Jbruslind/IntegratedStepper/README.md

# IntegratedStepper
Integrated Stepper Motor Node
