Jbruslind/IntegratedStepper/Mechanical/NEMA17_NEMA11_Adapter.SLDPRT

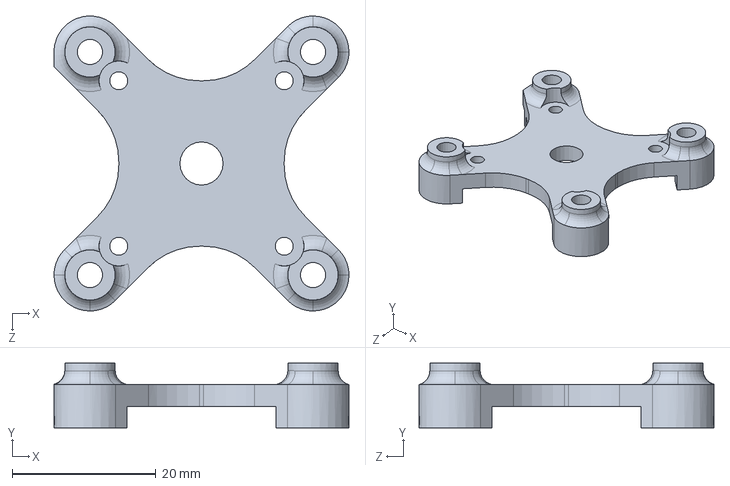
[picture p1: CAD file, 2024-04-22]
Mechanical/NEMA17_NEMA11_Adapter.SLDPRT
41.0 x 9.00 x 41.0 mm
