Jbruslind/IntegratedStepper/(list of files, cad)

Other CAD files:
Mechanical/NEMA17_NEMA11_Adapter.3MF
