Jbruslind/IntegratedStepper/PCB/IntegratedStepper/IntegratedStepper.kicad_pcb

## KiCad design PCB/IntegratedStepper/IntegratedStepper.kicad_pcb (2024-07-10)

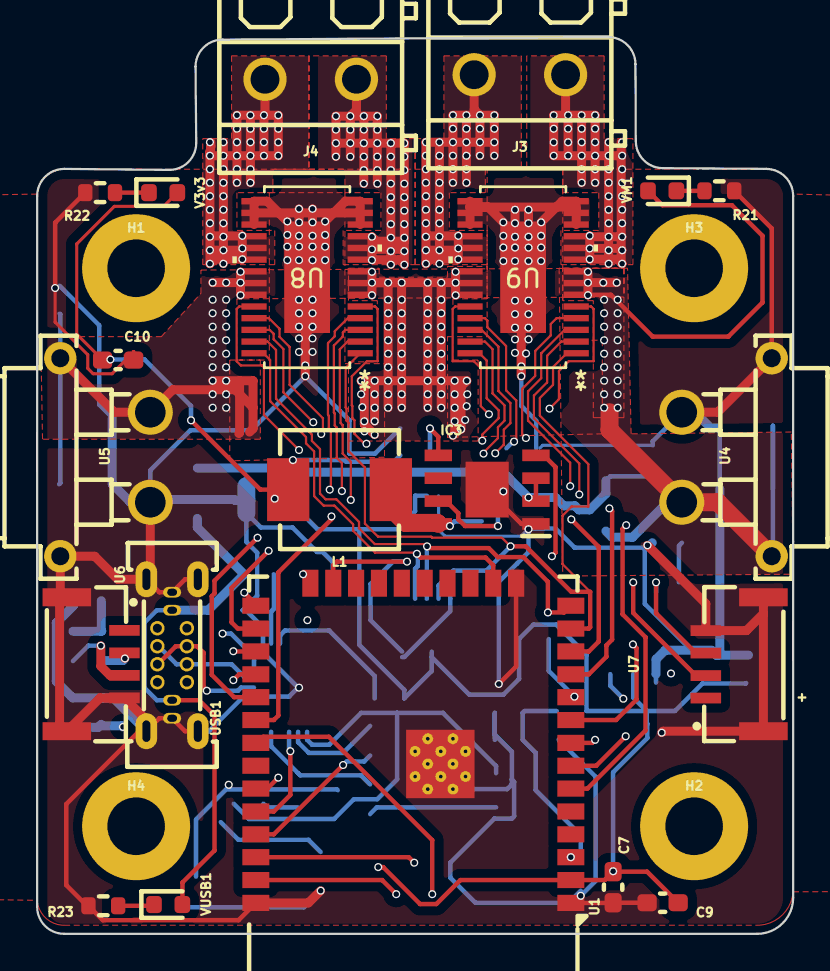
[picture p2: board IntegratedStepper.kicad_pcb from above]

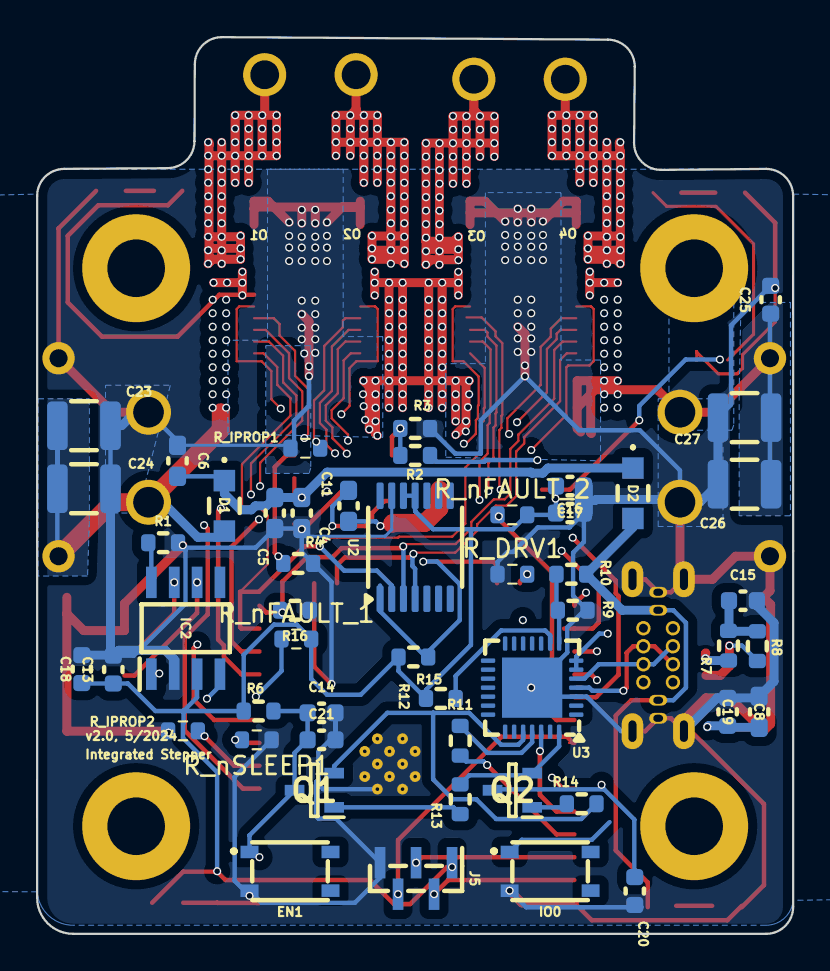
[picture p3: board IntegratedStepper.kicad_pcb from below]

Board: 4 copper layers, 42.0 x 49.8 mm, 75 parts (50 on the bottom side), 54 nets.

Parts:
C4, C7, C10: 10uf; C_0603_1608Metric_Pad1.08x0.95mm_HandSolder
C5, C9: 1uF; C_0603_1608Metric_Pad1.08x0.95mm_HandSolder
C6, C8: 100nf; C_0603_1608Metric_Pad1.08x0.95mm_HandSolder
C11: 0.1uF; C_0603_1608Metric_Pad1.08x0.95mm_HandSolder
C13, C14, C17, C18, C20, C21: 0.1uF; C_0603_1608Metric
C15: 4.7nF; C_0603_1608Metric
C16, C19, C25: 10uF; C_0603_1608Metric
C23: 22uF; C_1210_3225Metric
C24, C26, C27: 10uF; C_1210_3225Metric
D1, D2: PMEG6020ER,115; PMEG6020ER115
EN1: PTS815_SJG_250_SMTR_LFS; PTS815SJM250SMTRLFS
H1, H2, H3, H4: MountingHole_Pad; MountingHole_3.2mm_M3
IC2: SN65HVD230DR; SOT127P600X175-8N
IC3: LMR38020FSQDDARQ1; SOIC127P600X170-9N
IO0: PTS815_SJG_250_SMTR_LFS; PTS815SJM250SMTRLFS
J3, J4: Screw_Terminal_01x02; CONN-TH_P5.08_KF128-5.08-2P
J5: Conn_01x05_Socket; PinHeader_1x05_P1.00mm_Vertical_SMD_Pin1Left
L1: 10uH; IND-SMD_L7.2-W6.6_GPSR07X0
Q1, Q2: SS8050-G; SOT95P240X115-3N
R1, R13, R14, R15, R16, R21: 8.2k; R_0603_1608Metric
R2: 154k; R_0603_1608Metric
R3, R4: 64.9k; R_0603_1608Metric
R6: 10k; R_0603_1608Metric
R7, R8: 60; R_0603_1608Metric
R9: 47.5k; R_0603_1608Metric
R10: 22.1k; R_0603_1608Metric
R11: 10; R_0603_1608Metric
R12: 2k; R_0603_1608Metric
R22, R23: 500; R_0603_1608Metric
R_DRV1: 8.2k; R_0603_1608Metric
R_IPROP1, R_IPROP2: 820; R_0603_1608Metric
R_nFAULT_1, R_nFAULT_2: 8.2k; R_0603_1608Metric
R_nSLEEP1: 8.2k; R_0603_1608Metric
U1: ESP32-WROOM-32E; ESP32-WROOM-32D
U2: AS5048A; TSSOP-14_4.4x5mm_P0.65mm
U3: CP2102N-Axx-xQFN28; QFN-28-1EP_5x5mm_P0.5mm_EP3.35x3.35mm
U4, U5: XT30PW-F; CONN-TH_XT30PW-F-1
U6, U7: SM04B-GHS-TB(LF)(SN); CONN-SMD_4P-P1.25_SM04B-GHS-TB-LF-SN
U8, U9: PDRV8245SPWPQ1; U_PWP0028R_TEX
USB1: GT-USB-7038C; USB-C-TH_G-SWITCH_GT-USB-7038X
V3v3: LED; LED_0603_1608Metric
VM1: LED; LED_0603_1608Metric
VUSB1: LED; LED_0603_1608Metric

Connections:
3V3_VCC: C7.1, C8.1, C9.1, C10.1, C13.1, C16.1, C17.1, C18.1, C19.1, IC2.3 (VCC), J5.1, L1.2, R2.1, R6.1, R12.2, R15.2, R_nFAULT_1.2, R_nFAULT_2.2, U1.2 (VDD), U2.11 (VDD5V), U2.12 (VDD3V), U3.6 (VDD), U3.7 (VREGIN), V3v3.2 (A)
/3V3_VReg/VM: C23.1, C24.1, C25.1, C26.1, C27.1, D1.2 (A), U4.1, U4.4, U5.1, U5.4, U8.6 (VM), U8.7 (VM), U8.8 (VM), U8.21 (VM), U8.22 (VM), U8.23 (VM), U9.6 (VM), U9.7 (VM), U9.8 (VM), U9.21 (VM), U9.22 (VM), U9.23 (VM), VM1.2 (A)
/3V3_VReg/V_USB: D2.2 (A), R10.2, USB1.A4 (VBUS), USB1.A9 (VBUS), VUSB1.2 (A)
/CAN_Transciever/CAN_RX: IC2.4 (R), U1.28 (IO17)
/CAN_Transciever/CAN_TX: IC2.1 (D), U1.27 (IO16)
/DRV8245/DRV1_CS: U1.9 (IO33), U9.2 (NSCS)
/DRV8245/DRV2_CS: U1.33 (IO21), U8.2 (NSCS)
/DRV8245/DRVOFF: R_DRV1.2, U1.24 (IO2), U8.5 (DRVOFF), U9.5 (DRVOFF)
/DRV8245/M_MISO: R16.2, U1.14 (IO12), U2.3 (MISO), U8.27 (SDO), U9.27 (SDO)
/DRV8245/M_MOSI: U1.16 (IO13), U2.4 (MOSI), U8.28 (SDI), U9.28 (SDI)
/DRV8245/M_SCLK: U1.13 (IO14), U2.2 (CLK), U8.1 (SCLK), U9.1 (SCLK)
/DRV8245/NFAULT_1: R_nFAULT_1.1, U1.10 (IO25), U9.26 (NFAULT)
/DRV8245/NFAULT_2: R_nFAULT_2.1, U1.30 (IO18), U8.26 (NFAULT)
/DRV8245/NSLEEP: R_nSLEEP1.2, U1.8 (IO32), U8.24 (NSLEEP), U9.24 (NSLEEP)
/DRV8245/OUT1: J3.1, U9.9 (OUT1), U9.10 (OUT1), U9.11 (OUT1)
/DRV8245/OUT2: J3.2, U9.18 (OUT2), U9.19 (OUT2), U9.20 (OUT2)
/DRV8245/OUT3: J4.1, U8.9 (OUT1), U8.10 (OUT1), U8.11 (OUT1)
/DRV8245/OUT4: J4.2, U8.18 (OUT2), U8.19 (OUT2), U8.20 (OUT2)
/ESP32_MCU/ENC+: J5.3, U1.36 (IO22)
/ESP32_MCU/ENC-: J5.2, U1.37 (IO23)
/ESP32_MCU/ENC_IND: J5.4, U1.31 (IO19)
/ESP32_MCU/M_CS0: R15.1, U1.23 (IO15), U2.1 (~CSn)
CANH: IC2.6 (CANL), R7.1, U6.2, U7.2
CANL: IC2.7 (CANH), R8.2, U6.3, U7.3
DTR: Q2.2 (E), R13.1, U3.28 (~DTR)
EN: C14.1, C21.1, EN1.1 (COM_1), Q1.3 (C), R6.2, U1.3 (EN)
GND: C4.1, C5.1, C6.1, C7.2, C8.2, C9.2, C10.2, C13.2, C14.2, C15.2, C16.2, C17.2, C18.2, C19.2, C20.2, C21.2, C23.2, C24.2, C25.2, C26.2, C27.2, EN1.3 (NO_1), IC2.2 (GND), IC3.1 (GND), IC3.9 (EP), IO0.3 (NO_1), J5.5, R1.2, R3.2, R4.2, R9.2, R16.1, R21.1, R22.1, R23.1, R_DRV1.1, R_IPROP1.2, R_IPROP2.2, R_nSLEEP1.1, U1.1 (GND), U1.15 (GND), U1.38 (GND), U1.39 (GND), U2.13 (GND), U3.3 (GND), U3.29 (GND), U4.2, U4.3, U5.2, U5.3, U6.4, U6.5, U6.6, U7.4, U7.5, U7.6, U8.12 (GND), U8.13 (GND), U8.14 (GND), U8.15 (GND), U8.16 (GND), U8.17 (GND), U8.EPAD, U9.12 (GND), U9.13 (GND), U9.14 (GND), U9.15 (GND), U9.16 (GND), U9.17 (GND), U9.EPAD, USB1.13 (SHELL), USB1.A1 (GND), USB1.A12 (GND)
IN1: U1.11 (IO26), U9.4 (EN/IN1)
IN2: U1.12 (IO27), U9.3 (PH/IN2)
IN3: U1.29 (IO5), U8.4 (EN/IN1)
IN4: U1.26 (IO4), U8.3 (PH/IN2)
IO0: C20.1, IO0.1 (COM_1), Q2.3 (C), U1.25 (IO0)
IPROPI_1: R_IPROP1.1, U1.6 (IO34), U9.25 (IPROPI)
IPROPI_2: R_IPROP2.1, U1.7 (IO35), U8.25 (IPROPI)
unnamed: C15.1, R7.2, R8.1
unnamed: IC2.8 (RS), R1.1
unnamed: C11.1, IC3.7 (BOOT)
unnamed: IC3.5 (FB), R2.2, R3.1
unnamed: IC3.4 (RT/SYNC), R4.1
unnamed: C11.2, IC3.8 (SW), L1.1
unnamed: Q1.1 (B), R13.2
unnamed: Q2.1 (B), R14.2
unnamed: R11.2, U1.35 (TXD0/IO1)
unnamed: R9.1, R10.1, U3.8 (VBUS)
unnamed: R12.1, U3.9 (~RST)
unnamed: R22.2, V3v3.1 (K)
unnamed: R21.2, VM1.1 (K)
unnamed: R23.2, VUSB1.1 (K)
RTS: Q1.2 (E), R14.1, U3.24 (~RTS)
RX: U1.34 (RXD0/IO3), U3.26 (TXD)
TX: R11.1, U3.25 (RXD)
USB_D+: U3.4 (D+), USB1.A6 (Dp1), USB1.B6 (Dp2)
USB_D-: U3.5 (D-), USB1.A7 (Dn1), USB1.B7 (Dn2)
VIN: C4.2, C5.2, C6.2, D1.1 (K), D2.1 (K), IC3.2 (EN), IC3.3 (VIN)
