Jbruslind/IntegratedStepper/TestBoards/DRV-Tester/DRV-Tester/DRV-Tester.kicad_pcb

## KiCad design TestBoards/DRV-Tester/DRV-Tester/DRV-Tester.kicad_pcb (2024-07-03)

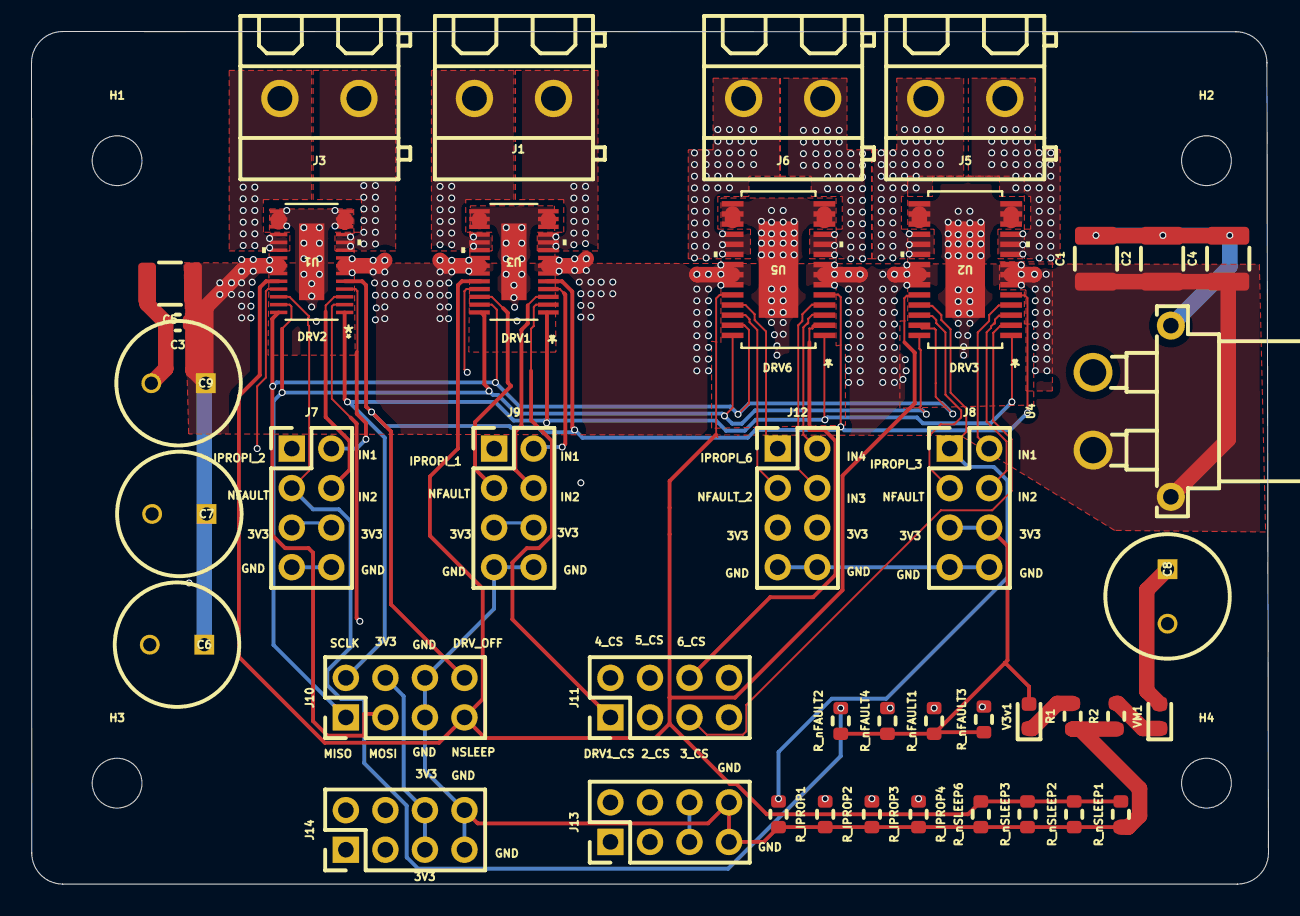
[picture p4: board DRV-Tester.kicad_pcb from above]

Board: 4 copper layers, 79.5 x 54.8 mm, 46 parts (0 on the bottom side), 38 nets.

Parts:
C1: 22uF; C_1210_3225Metric
C2, C4, C5: 10uF; C_1210_3225Metric
C3: 10uF; C_0603_1608Metric
C6, C7, C8, C9: EEU-FC1J101LB; CAPPRD350W65D800H1650
H1, H2, H3, H4: MountingHole_Pad; MountingHole_3.2mm_M3
J1, J3, J5, J6: Screw_Terminal_01x02; CONN-TH_P5.08_KF128-5.08-2P
J7, J8, J9, J10, J11, J12, J13, J14: Conn_02x04_Odd_Even; PinHeader_2x04_P2.54mm_Vertical
R1: 500; R_0603_1608Metric
R2: 8.2k; R_0603_1608Metric
R_IPROP1, R_IPROP2, R_IPROP3, R_IPROP4: 820; R_0603_1608Metric
R_nFAULT1, R_nFAULT2, R_nFAULT3, R_nFAULT4: 820; R_0603_1608Metric
R_nSLEEP1, R_nSLEEP2, R_nSLEEP3, R_nSLEEP6: 8.2k; R_0603_1608Metric
U1: PDRV8244SPWPQ1; U_DGQ0028A_TEX-L
U2, U5: PDRV8245SPWPQ1; U_PWP0028R_TEX
U3: PDRV8243SPWPQ1; VSSOP_SDGQQ1_TEX
U4: XT30PW-F; CONN-TH_XT30PW-F-1
V3v1: LED; LED_0603_1608Metric
VM1: LED; LED_0603_1608Metric

Connections:
3V3: J7.5, J7.6, J8.5, J8.6, J9.5, J9.6, J10.4, J12.5, J12.6, J13.5, J13.6, J14.5, J14.6, R_nFAULT1.1, R_nFAULT2.1, R_nFAULT3.1, R_nFAULT4.1, V3v1.2 (A)
/DRV1_GPIO1/IN1: J7.2, U1.4 (EN/IN1)
/DRV1_GPIO1/IN2: J7.4, U1.3 (PH/IN2)
/DRV1_GPIO1/N_FAULT: J7.3, R_nFAULT2.2, U1.26 (NFAULT)
/DRV1_GPIO2/IN1: J9.2, U3.4 (EN/IN1)
/DRV1_GPIO2/IN2: J9.4, U3.3 (PH/IN2)
/DRV1_GPIO2/N_FAULT: J9.3, R_nFAULT1.2, U3.26 (NFAULT)
/DRV1_GPIO/IN1: J8.2, U2.4 (EN/IN1)
/DRV1_GPIO/IN2: J8.4, U2.3 (PH/IN2)
/DRV1_GPIO/IN3: J12.4, U5.4 (EN/IN1)
/DRV1_GPIO/IN4: J12.2, U5.3 (PH/IN2)
/DRV1_GPIO/N_FAULT: J8.3, R_nFAULT3.2, U2.26 (NFAULT)
/DRV1_GPIO/N_FAULT2: J12.3, R_nFAULT4.2, U5.26 (NFAULT)
/DRV8243/OUT1: J1.1, U3.9 (OUT1), U3.10 (OUT1), U3.11 (OUT1)
/DRV8243/OUT2: J1.2, U3.18 (OUT2), U3.19 (OUT2), U3.20 (OUT2)
/DRV8244/OUT1: J3.1, U1.9 (OUT1), U1.10 (OUT1), U1.11 (OUT1)
/DRV8244/OUT2: J3.2, U1.18 (OUT2), U1.19 (OUT2), U1.20 (OUT2)
/DRV8245/OUT1: J5.1, U2.9 (OUT1), U2.10 (OUT1), U2.11 (OUT1)
/DRV8245/OUT2: J5.2, U2.18 (OUT2), U2.19 (OUT2), U2.20 (OUT2)
/DRV8245/OUT3: J6.1, U5.9 (OUT1), U5.10 (OUT1), U5.11 (OUT1)
/DRV8245/OUT4: J6.2, U5.18 (OUT2), U5.19 (OUT2), U5.20 (OUT2)
DRV1_CS: J11.1, U3.2 (NSCS)
DRV2_CS: J11.3, U1.2 (NSCS)
DRV3_CS: J11.5, U2.2 (NSCS)
DRV6_CS: J11.6, U5.2 (NSCS)
DRV_OFF: J10.8, U1.5 (DRVOFF), U2.5 (DRVOFF), U3.5 (DRVOFF), U5.5 (DRVOFF)
GND: C1.2, C2.2, C3.2, C4.2, C5.2, C6.2 (-), C7.2 (-), C8.2 (-), C9.2 (-), J7.7, J7.8, J8.7, J8.8, J9.7, J9.8, J10.5, J10.6, J12.7, J12.8, J13.7, J13.8, J14.7, J14.8, R1.1, R2.1, R_IPROP1.2, R_IPROP2.2, R_IPROP3.2, R_IPROP4.2, R_nSLEEP1.1, R_nSLEEP2.1, R_nSLEEP3.1, R_nSLEEP6.1, U1.12 (GND), U1.13 (GND), U1.14 (GND), U1.15 (GND), U1.16 (GND), U1.17 (GND), U1.EPAD, U2.12 (GND), U2.13 (GND), U2.14 (GND), U2.15 (GND), U2.16 (GND), U2.17 (GND), U2.EPAD, U3.12 (GND), U3.13 (GND), U3.14 (GND), U3.15 (GND), U3.16 (GND), U3.17 (GND), U3.EPAD, U4.2, U4.3, U5.12 (GND), U5.13 (GND), U5.14 (GND), U5.15 (GND), U5.16 (GND), U5.17 (GND), U5.EPAD
IPROPI_1: J9.1, R_IPROP3.1
IPROPI_2: J7.1, R_IPROP2.1, U1.25 (IPROPI), U3.25 (IPROPI)
IPROPI_3: J8.1, R_IPROP1.1, U2.25 (IPROPI)
IPROPI_6: J12.1, R_IPROP4.1, U5.25 (IPROPI)
M_MISO: J10.1, U1.27 (SDO), U2.28 (SDI), U3.28 (SDI), U5.28 (SDI)
M_MOSI: J10.3, U1.28 (SDI), U2.27 (SDO), U3.27 (SDO), U5.27 (SDO)
M_SCLK: J10.2, U1.1 (SCLK), U2.1 (SCLK), U3.1 (SCLK), U5.1 (SCLK)
NSLEEP: J10.7, R_nSLEEP1.2, R_nSLEEP2.2, R_nSLEEP3.2, R_nSLEEP6.2, U1.24 (NSLEEP), U2.24 (NSLEEP), U3.24 (NSLEEP), U5.24 (NSLEEP)
unnamed: R1.2, V3v1.1 (K)
unnamed: R2.2, VM1.1 (K)
VM: C1.1, C2.1, C3.1, C4.1, C5.1, C6.1 (+), C7.1 (+), C8.1 (+), C9.1 (+), U1.6 (VM), U1.7 (VM), U1.8 (VM), U1.21 (VM), U1.22 (VM), U1.23 (VM), U2.6 (VM), U2.7 (VM), U2.8 (VM), U2.21 (VM), U2.22 (VM), U2.23 (VM), U3.6 (VM), U3.7 (VM), U3.8 (VM), U3.21 (VM), U3.22 (VM), U3.23 (VM), U4.1, U4.4, U5.6 (VM), U5.7 (VM), U5.8 (VM), U5.21 (VM), U5.22 (VM), U5.23 (VM), VM1.2 (A)
