Jbruslind/IntegratedStepper/Firmware/SimpleFOC_ESP32/src/main.cpp

#include <SimpleFOC.h>
#include <drv824x_driver.h>
// #include <SimpleFOCCAN.h>

#define CAN_TX 16
#define CAN_RX 17

#define nSLEEP 32
#define DRVOFF 2

#define nFAULT_1 25
#define nFAULT_2 18

#define IPROPI_1 33
#define IPROPI_2 35

#define A_p 1/3070
#define R_IPROP 820

TaskHandle_t moveMotors;
void moveMotorsfun( void * pvParameters);
// Stepper motor instance
StepperMotor motor = StepperMotor(50);
SPIClass* hspi = new SPIClass(HSPI); 
// Stepper driver instance
// DRV824X_2PH(int ph1A,int ph1B, int en = NOT_SET, int nsleep = NOT_SET, int nCS = NOT_SET,
//     SPISettings settings = DRV824xSPISettings, SPIClass* _spi = &SPI);
DRV824X_2PH driver_1 = DRV824X_2PH(26, 27, 33, DRV824xSPISettings, hspi);
DRV824X_2PH driver_2 = DRV824X_2PH(4, 5, 21, DRV824xSPISettings, hspi);


DRV824X_4PH driver = DRV824X_4PH(driver_1, driver_2);
MagneticSensorSPI sensor = MagneticSensorSPI(AS5048_SPI, 15);


// LowsideCurrentSense current_sense = LowsideCurrentSense(A_p, R_IPROP, IPROPI_1, IPROPI_2);

// CANDriver can = CANDriver(CAN_TX, CAN_RX);
// CANCommander canCommand = CANCommander(can);
Commander command = Commander(Serial);

void onMotor(char* cmd){ command.motor(&motor, cmd); }
// void doCommanderCAN(char* cmd) { canCommand.motor(&motor, cmd); }

void setup() {
  Serial.begin(115200);
  Serial.print("RUNNING ON CORE: ");
  Serial.println(xPortGetCoreID());

  pinMode(nSLEEP, OUTPUT);
  pinMode(DRVOFF, OUTPUT);

  digitalWrite(nSLEEP, HIGH);
  digitalWrite(DRVOFF, LOW);

  disableCore0WDT();
  xTaskCreatePinnedToCore(
                      moveMotorsfun,   /* Task function. */
                      "Command Motors",     /* name of task. */
                      100000,       /* Stack size of task */
                      NULL,        /* parameter of the task */
                      2,           /* priority of the task */
                      &moveMotors,      /* Task handle to keep track of created task */
                      0);          /* pin task to core 0 */                  
  delay(500); 

  // define the motor id
    // comment out if not needed
  motor.useMonitoring(Serial);
  command.add('M', onMotor, "motor");
  // canCommand.add('M', doCommanderCAN, (char*)"motor");

  _delay(1000);
}


void moveMotorsfun( void * pvParameters) {
  motor.voltage_sensor_align = 5;
  // pwm frequency to be used [Hz]
  // driver.pwm_frequency = 20000;
  // power supply voltage [V]
  driver.voltage_power_supply = 19;
  // Max DC voltage allowed - default voltage_power_supply

  // ##################### ENCODER CONFIG
  // encoder.quadrature = Quadrature::ON;

  // encoder.pullup = Pullup::USE_INTERN;
  // encoder.init();
  // encoder.enableInterrupts(doA, doB);
  // motor.linkSensor(&encoder);

  // ##################### I2C CONFIG
  // sensor.init();
  // motor.linkSensor(&sensor);

  // ##################### SPI CONFIG
  sensor.init(hspi);
  motor.linkSensor(&sensor);


  // choose FOC modulation
  motor.foc_modulation = FOCModulationType::SinePWM;
  motor.torque_controller = TorqueControlType::voltage;
  motor.controller = MotionControlType::angle_openloop;

  // power supply voltage [V]
  driver.voltage_power_supply = 19;
  // motor.motion_downsample = 2;
  // printf("Driver1 config2: %x \n", driver.driver1.getConfig2().data);
  // printf("Driver1 config3: %x \n", driver.driver1.getConfig3().data);
  // printf("Driver1 config4: %x \n", driver.driver1.getConfig4().data);

  driver.init();

  // link the motor to the sensor
  motor.linkDriver(&driver);

  // set control loop type to be used]
  
  driver.pwm_frequency = 20000;
  driver.voltage_limit = driver.voltage_power_supply / 2;
  motor.voltage_limit = driver.voltage_power_supply / 2;
  
  // controller configuration based on the control type 
  motor.PID_velocity.P = 2;
  motor.PID_velocity.I = 20;
  motor.PID_velocity.D = 0;
  motor.LPF_velocity.Tf = 0.009;

  // angle loop controller
  motor.P_angle.P = 20;
  motor.P_angle.D = 0;
  // angle loop velocity limit
  motor.velocity_limit = 5;
  motor.current_limit = 4;
  motor.phase_resistance = 0.9;
  motor.phase_inductance = 0.00280;
  
  
  // use monitoring with serial for motor init
  // monitoring port
  
  // current_sense.linkDriver(&driver);
  // current_sense.init();

  motor.monitor_downsample = 1000;
  // initialise motor
  motor.monitor_variables =  _MON_TARGET | _MON_VOLT_Q | _MON_VOLT_D | _MON_VEL | _MON_ANGLE; 
  motor.init();
  // align encoder and start FOC
  motor.initFOC();

  printf("Driver2: %x \n", driver.driver2.getDeviceID());
  printf("Driver2 fault: %x \n", driver.driver2.getFault());
  printf("Driver2 config1: %x \n", driver.driver2.getConfig1().data);

  printf("Driver1: %x \n", driver.driver1.getDeviceID());
  printf("Driver1 fault: %x \n", driver.driver1.getFault());
  printf("Driver1 config1: %x \n", driver.driver1.getConfig1().data);

    for(;;){
        //This function keeps motors spinning and must be run as fast as possible
        motor.move();
        motor.loopFOC();
    }
}

void loop() {
  command.run();
  // motor.monitor();
  if((driver.driver1.getStatus1().status.FAULT || driver.driver2.getStatus1().status.FAULT) && !(driver.driver1.getStatus1().status.SPI_ERR || driver.driver2.getStatus1().status.SPI_ERR))
  {
    printf("MOTOR FAULT | M1 %x | M2 %x \n", driver.driver1.getStatus1().data, 
    driver.driver2.getStatus1().data);
    if(driver.driver1.getStatus1().status.TSD || driver.driver2.getStatus1().status.TSD){
      printf("OVERTEMP!!! Waiting to cool down \n");
    }
    else{
      driver.clear();
    }
    
  }
  // canCommand.runWithCAN();
}
