Jbruslind/IntegratedStepper/(commit log)

2024-04-19 Move files to individual repo
    [3V3_VReg.kicad_sch, DRV8844.kicad_sch, ESP32_MCU.kicad_sch, Input_RJ45.kicad_sch, IntegratedStepper.kicad_pcb, IntegratedStepper.kicad_sch, Magnetic_Encoder.kicad_sch, RS485.kicad_sch]
2024-04-22 add NEMA 17 adapter for drivers
    [NEMA17_NEMA11_Adapter.3MF, NEMA17_NEMA11_Adapter.SLDPRT]
2024-05-05 init PCB dev area
    [Input_RJ45.kicad_sch, IntegratedStepper.kicad_pcb]
2024-05-10 Update PCB with DRV8243 for 12A capacity
    [DRV8844.kicad_sch, ESP32_MCU.kicad_sch, Input_RJ45.kicad_sch, IntegratedStepper.kicad_pcb, IntegratedStepper.kicad_sch, Stepper_Outputs.kicad_sch]
2024-05-14 update layout temp
    [DRV8844.kicad_sch, Input_RJ45.kicad_sch, IntegratedStepper.kicad_pcb]
2024-05-14 update layout to XT30 + 3.5mm Jack
    [Input_RJ45.kicad_sch, IntegratedStepper.kicad_pcb]
2024-05-15 update layout with pinout changes
    [DRV8844.kicad_sch, ESP32_MCU.kicad_sch, Input_RJ45.kicad_sch, IntegratedStepper.kicad_pcb]
2024-05-16 finalize layout w/ thermals
    [ESP32_MCU.kicad_sch, IntegratedStepper.kicad_pcb]
2024-05-20 Update final layout, replace CAN w/ JST
    [ESP32_MCU.kicad_sch, Input_RJ45.kicad_sch, IntegratedStepper.kicad_pcb, Magnetic_Encoder.kicad_sch, RS485.kicad_sch, bom.csv, designators.csv, positions.csv]
2024-06-10 add test board PCB
    [DRV-Tester.kicad_pcb, DRV-Tester.kicad_sch, DRV8243.kicad_sch, DRV8244.kicad_sch, DRV8245.kicad_sch, Input_RJ45.kicad_sch, Stepper_Outputs.kicad_sch]
2024-06-12 update new tester board sch
    [COM_GPIO.kicad_sch, DRV-Tester.kicad_pcb, DRV-Tester.kicad_sch, DRV8243.kicad_sch, DRV8244.kicad_sch, DRV8245.kicad_sch, DRV8844.kicad_sch, DRV_GPIO.kicad_sch]
2024-06-14 update new layout with DRV8245
    [DRV8844.kicad_sch, ESP32_MCU.kicad_sch, IntegratedStepper.kicad_pcb, Stepper_Outputs.kicad_sch]
2024-06-15 update layout for larger pcb
    [IntegratedStepper.kicad_pcb, bom.csv, designators.csv, positions.csv]
2024-06-16 Update semi-final layout for HVSSOP DRV8245
    [IntegratedStepper.kicad_pcb]
2024-06-17 update tester board with layout
    [COM_GPIO.kicad_sch, DRV-Tester.kicad_pcb, DRV-Tester.kicad_sch, DRV8243.kicad_sch, DRV8244.kicad_sch, DRV8245.kicad_sch, DRV_GPIO.kicad_sch, Input_RJ45.kicad_sch]
2024-06-18 finish layout for stupid lil test board
    [DRV-Tester.kicad_pcb]
2024-06-19 add caps and LEDs to testboard
    [COM_GPIO.kicad_sch, DRV-Tester.kicad_pcb, DRV-Tester.kicad_sch, DRV_GPIO.kicad_sch, Stepper_Outputs_2.kicad_sch]
2024-07-03 Create initial driver for DRV824x drivers for ESP32 / SimpleFOC
    [3V3_VReg.kicad_sch, DRV-Tester.kicad_pcb, DRV8844.kicad_sch, ESP32_MCU.kicad_sch, Input_RJ45.kicad_sch, IntegratedStepper.kicad_pcb, IntegratedStepper.kicad_sch, Magnetic_Encoder.kicad_sch]
2024-07-04 update driver to be modular based on single DRV
2024-07-07 updated CS to be on IO instead of just input pin
    [ESP32_MCU.kicad_sch, IntegratedStepper.kicad_pcb]
2024-07-10 update pinout for ESP32
    [ESP32_MCU.kicad_sch]
